Hishamidrees/BAREEQ-CARWASH/backend/versions/README.md

# Backend Versions

Older iterations of the BAREEQ backend kept for reference.

| File | Description |
|---|---|
| `Backend_Deployed.py` | Deployed variant using pymysql direct (no Cloud SQL connector) |
| `BackendV4.py` | Previous stable version |
| `BackendV3.py` | Earlier version |
| `BestVER.py` | Older stable version |

The current production backend is `../app.py`.
