Hishamidrees/BAREEQ-CARWASH/(notices)

Notices in the files:
README.md:
License: MIT
